MechDeck-Allen/butterfly-flapping-robot/design/SolidWorks/wing_bracket.SLDPRT

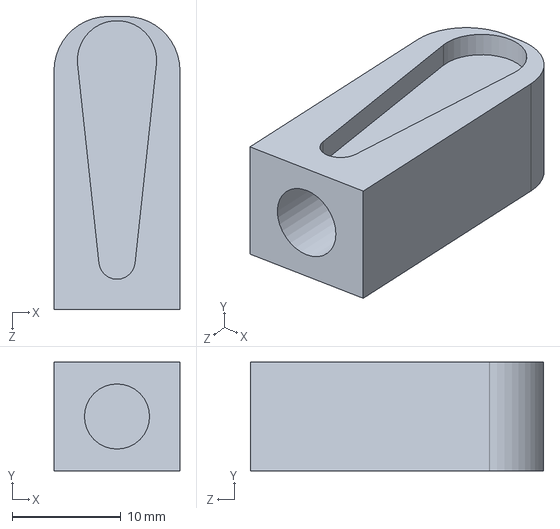
[picture p7: CAD file, 2026-10-29]
design/SolidWorks/wing_bracket.SLDPRT
11.6 x 10.0 x 27.0 mm
