MechDeck-Allen/butterfly-flapping-robot/design/SolidWorks/body.SLDPRT

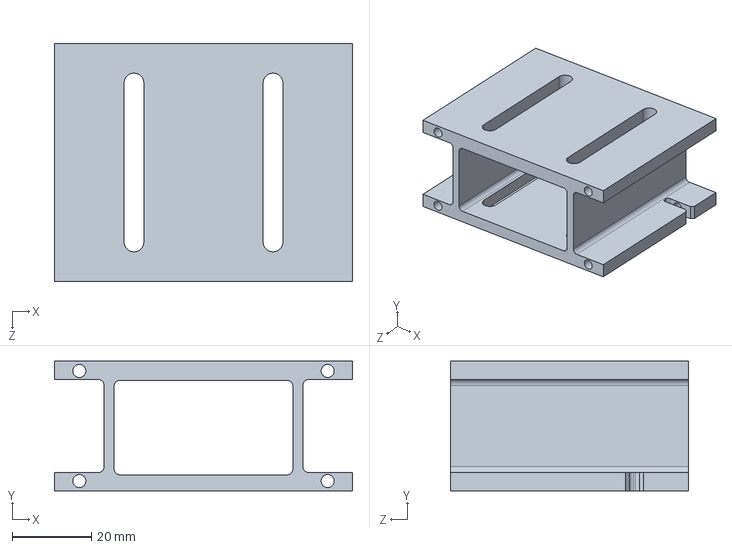
[picture p8: CAD file, 2026-10-29]
design/SolidWorks/body.SLDPRT
75.0 x 32.6 x 60.0 mm
