MechDeck-Allen/butterfly-flapping-robot/(list of files, cad)

Other CAD files:
design/STL/wing_bracket.STL
