MechDeck-Allen/butterfly-flapping-robot/(commit log)

2026-10-29 Initial commit: Butterfly flapping robot
    [body.SLDPRT, wing_bracket.SLDPRT, wing_bracket.STL]
2026-10-29 Fix repository root structure
    [body.SLDPRT, wing_bracket.SLDPRT, wing_bracket.STL]
